jmorris-harvard/Bionics/README.txt

NanoDesign x Bionics Collab File Storage
