jmorris-harvard/Bionics/src/xil/nipcb/src/rtl/peripherals/ahb_defs.v

/**************************************************************************//**
 * @file     ahb_defs.v
 * @brief    Definition for AHB signal values
 * @version  v0.1
 * @date     10. March 2023
 *
 * @notes
 *
 ******************************************************************************/


`define AHB_RSP_OKAY  1'b0
`define AHB_RSP_ERROR 1'b1
