jmorris-harvard/Bionics/(commit log)

2024-09-27 Added pcb files
    [NIPCB.brd, NIPCB.sch]
2024-09-27 Added xdc files
    [xem7310.csv]
2024-10-27 Flow works
2024-11-08 added working software interface files
    [out.csv]
2024-11-08 Added READMEs
    [out.csv]
